ojeffreyo/PSVB_EvalBoard/pics/PSVB_EvalBoard_Top.jpg

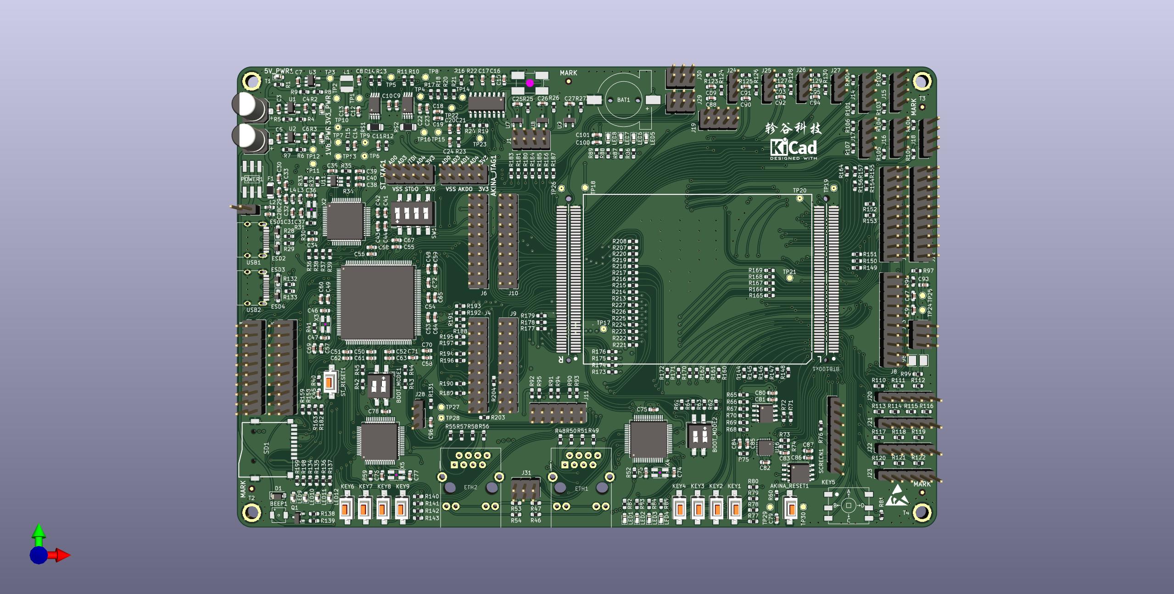
pics/PSVB_EvalBoard_Top.jpg
