ojeffreyo/PSVB_EvalBoard/pics/mimo.jpg

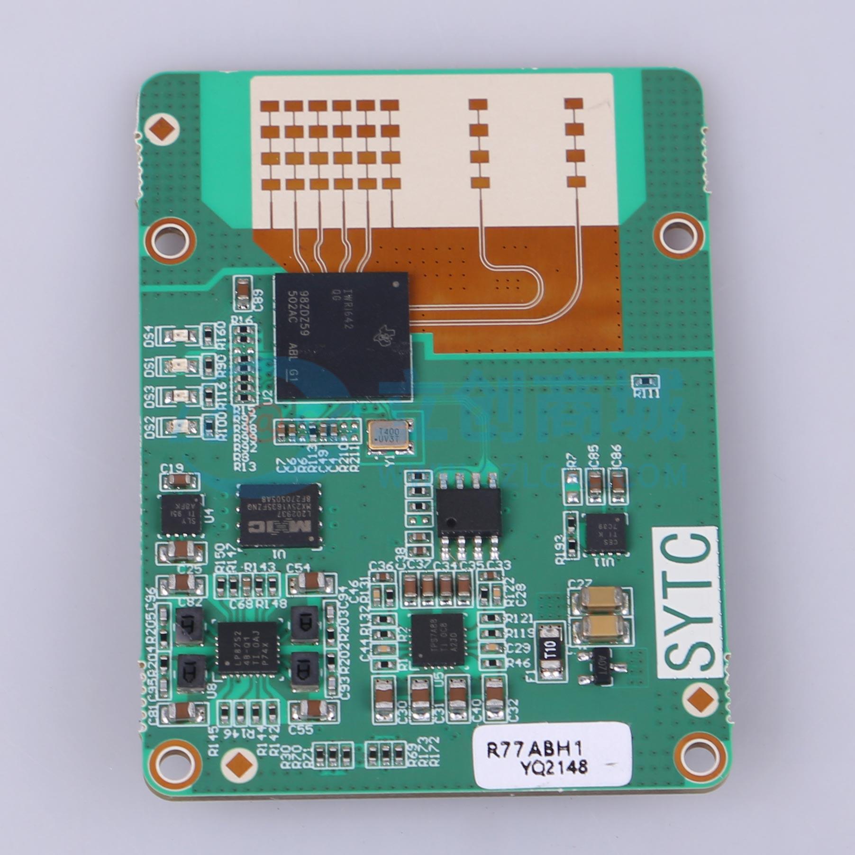
pics/mimo.jpg
