ojeffreyo/PSVB_EvalBoard/README.md

# PSVB_EvalBoard
Hardware for SoC test designed by myself.
