ojeffreyo/PSVB_EvalBoard/Layout_PDF/嘉立创SMT订单核对_PSVB_GerberV1_2023-5-18.pdf

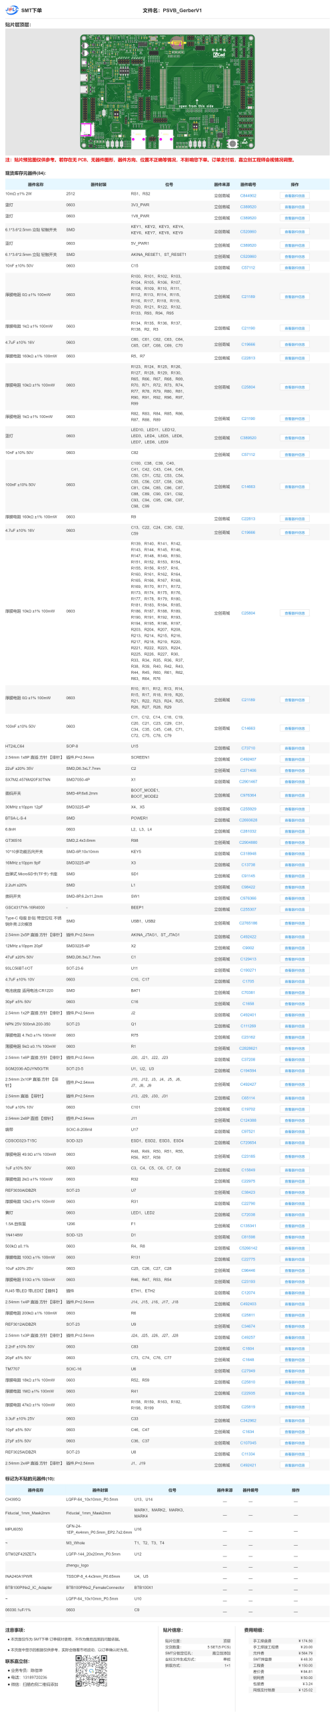
[picture p3: page 1]

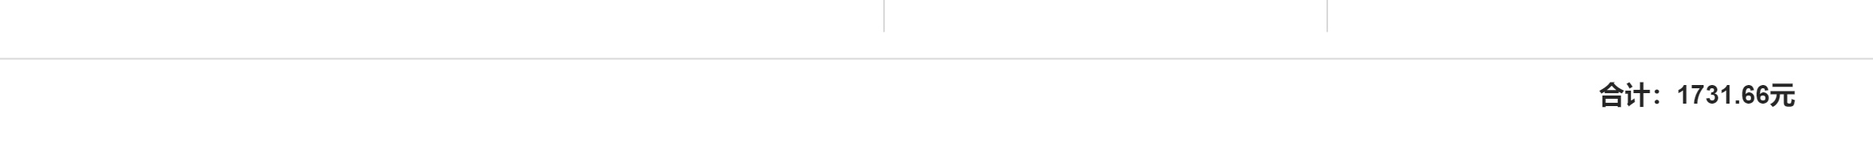
[picture p4: figure]
