ojeffreyo/PSVB_EvalBoard/datasheets/BTB_公座.png

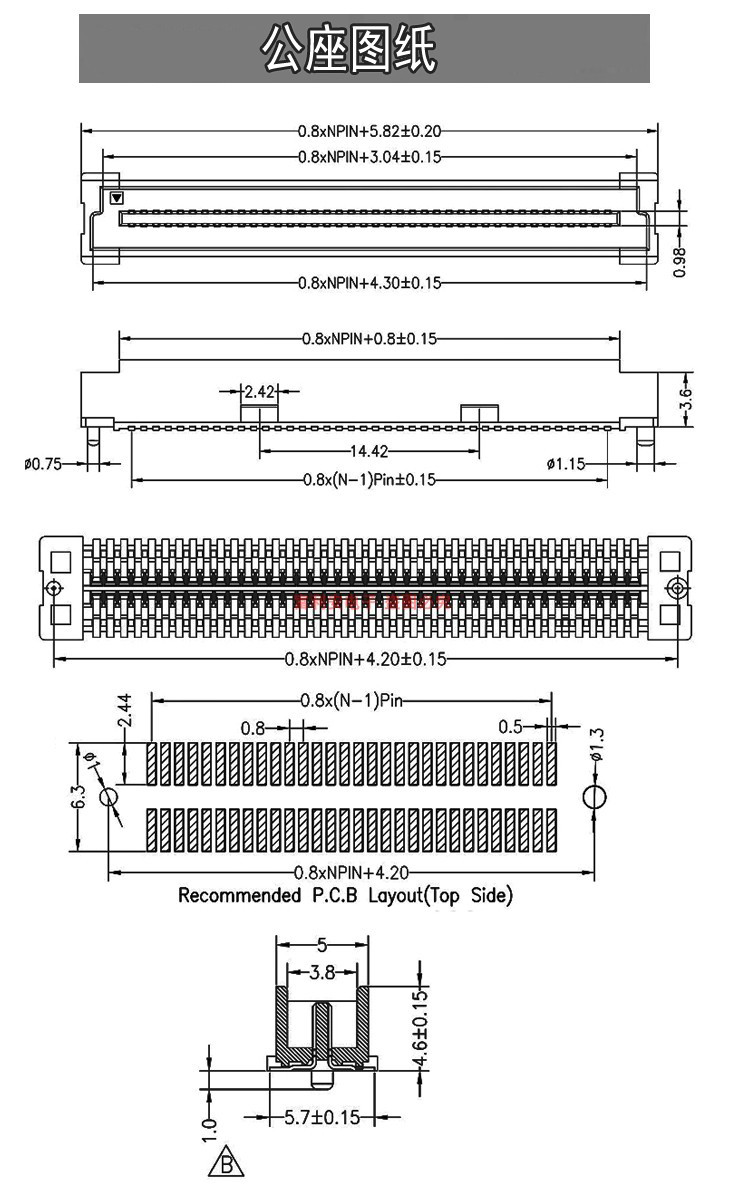
datasheets/BTB_公座.png
