ojeffreyo/PSVB_EvalBoard/datasheets/BTB_母座.png

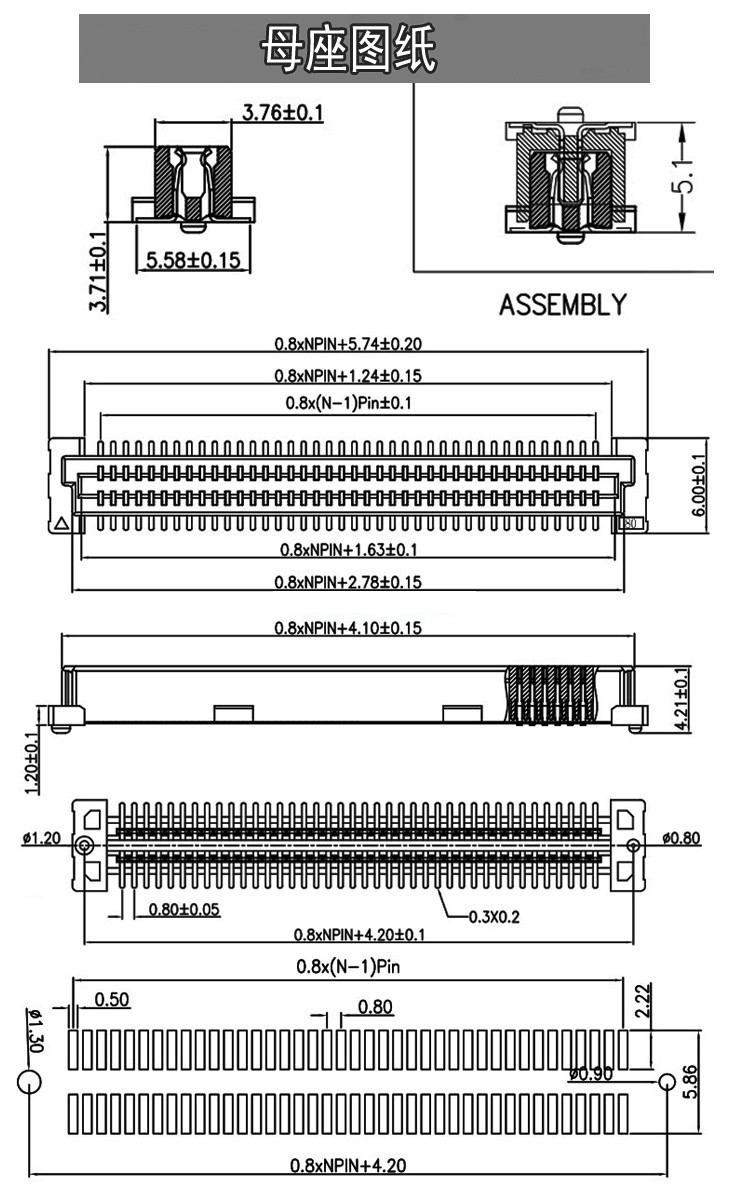
datasheets/BTB_母座.png
