ojeffreyo/PSVB_EvalBoard/pics/pic2.jpg

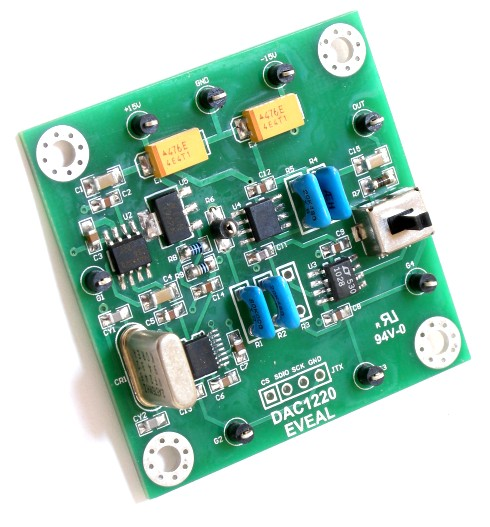
pics/pic2.jpg
