ojeffreyo/PSVB_EvalBoard/pics/PSVB_EvalBoard2.jpg

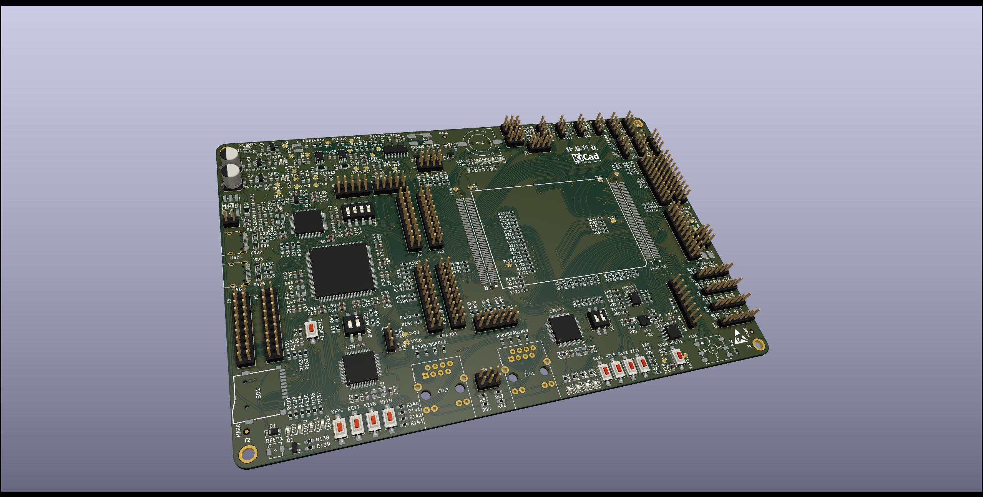
pics/PSVB_EvalBoard2.jpg
