ojeffreyo/PSVB_EvalBoard/pics/PSVB_EvalBoard.jpg

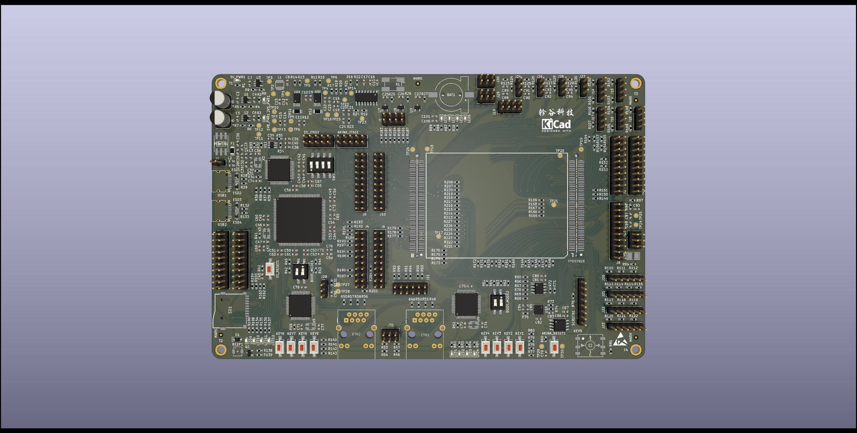
pics/PSVB_EvalBoard.jpg
