ojeffreyo/PSVB_EvalBoard/pics/PSVB_EvalBoard_Bottom.jpg

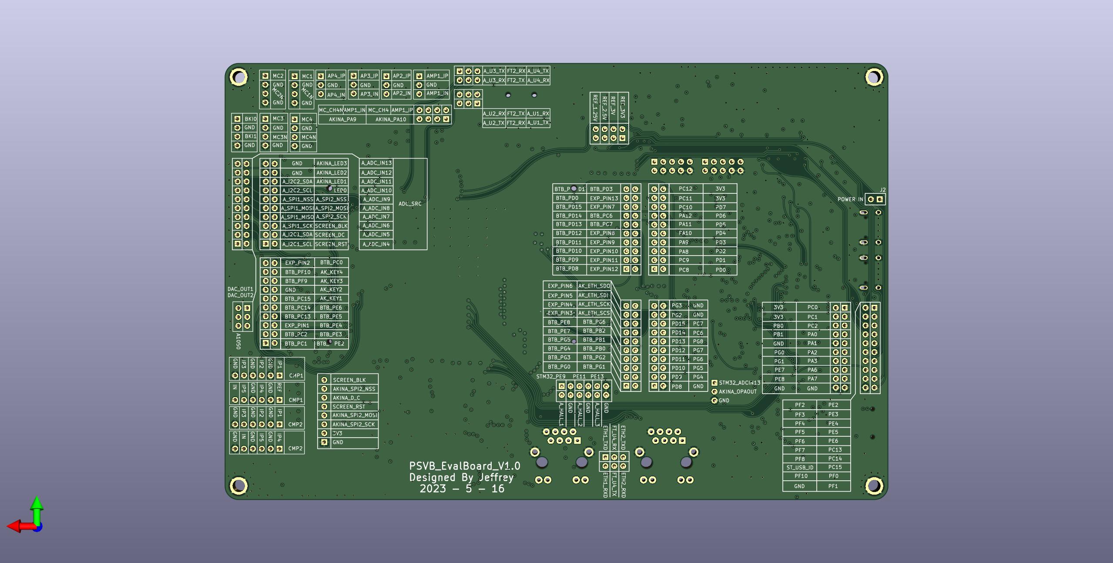
pics/PSVB_EvalBoard_Bottom.jpg
