ojeffreyo/PSVB_EvalBoard/PSVB_EvalBoard.pdf

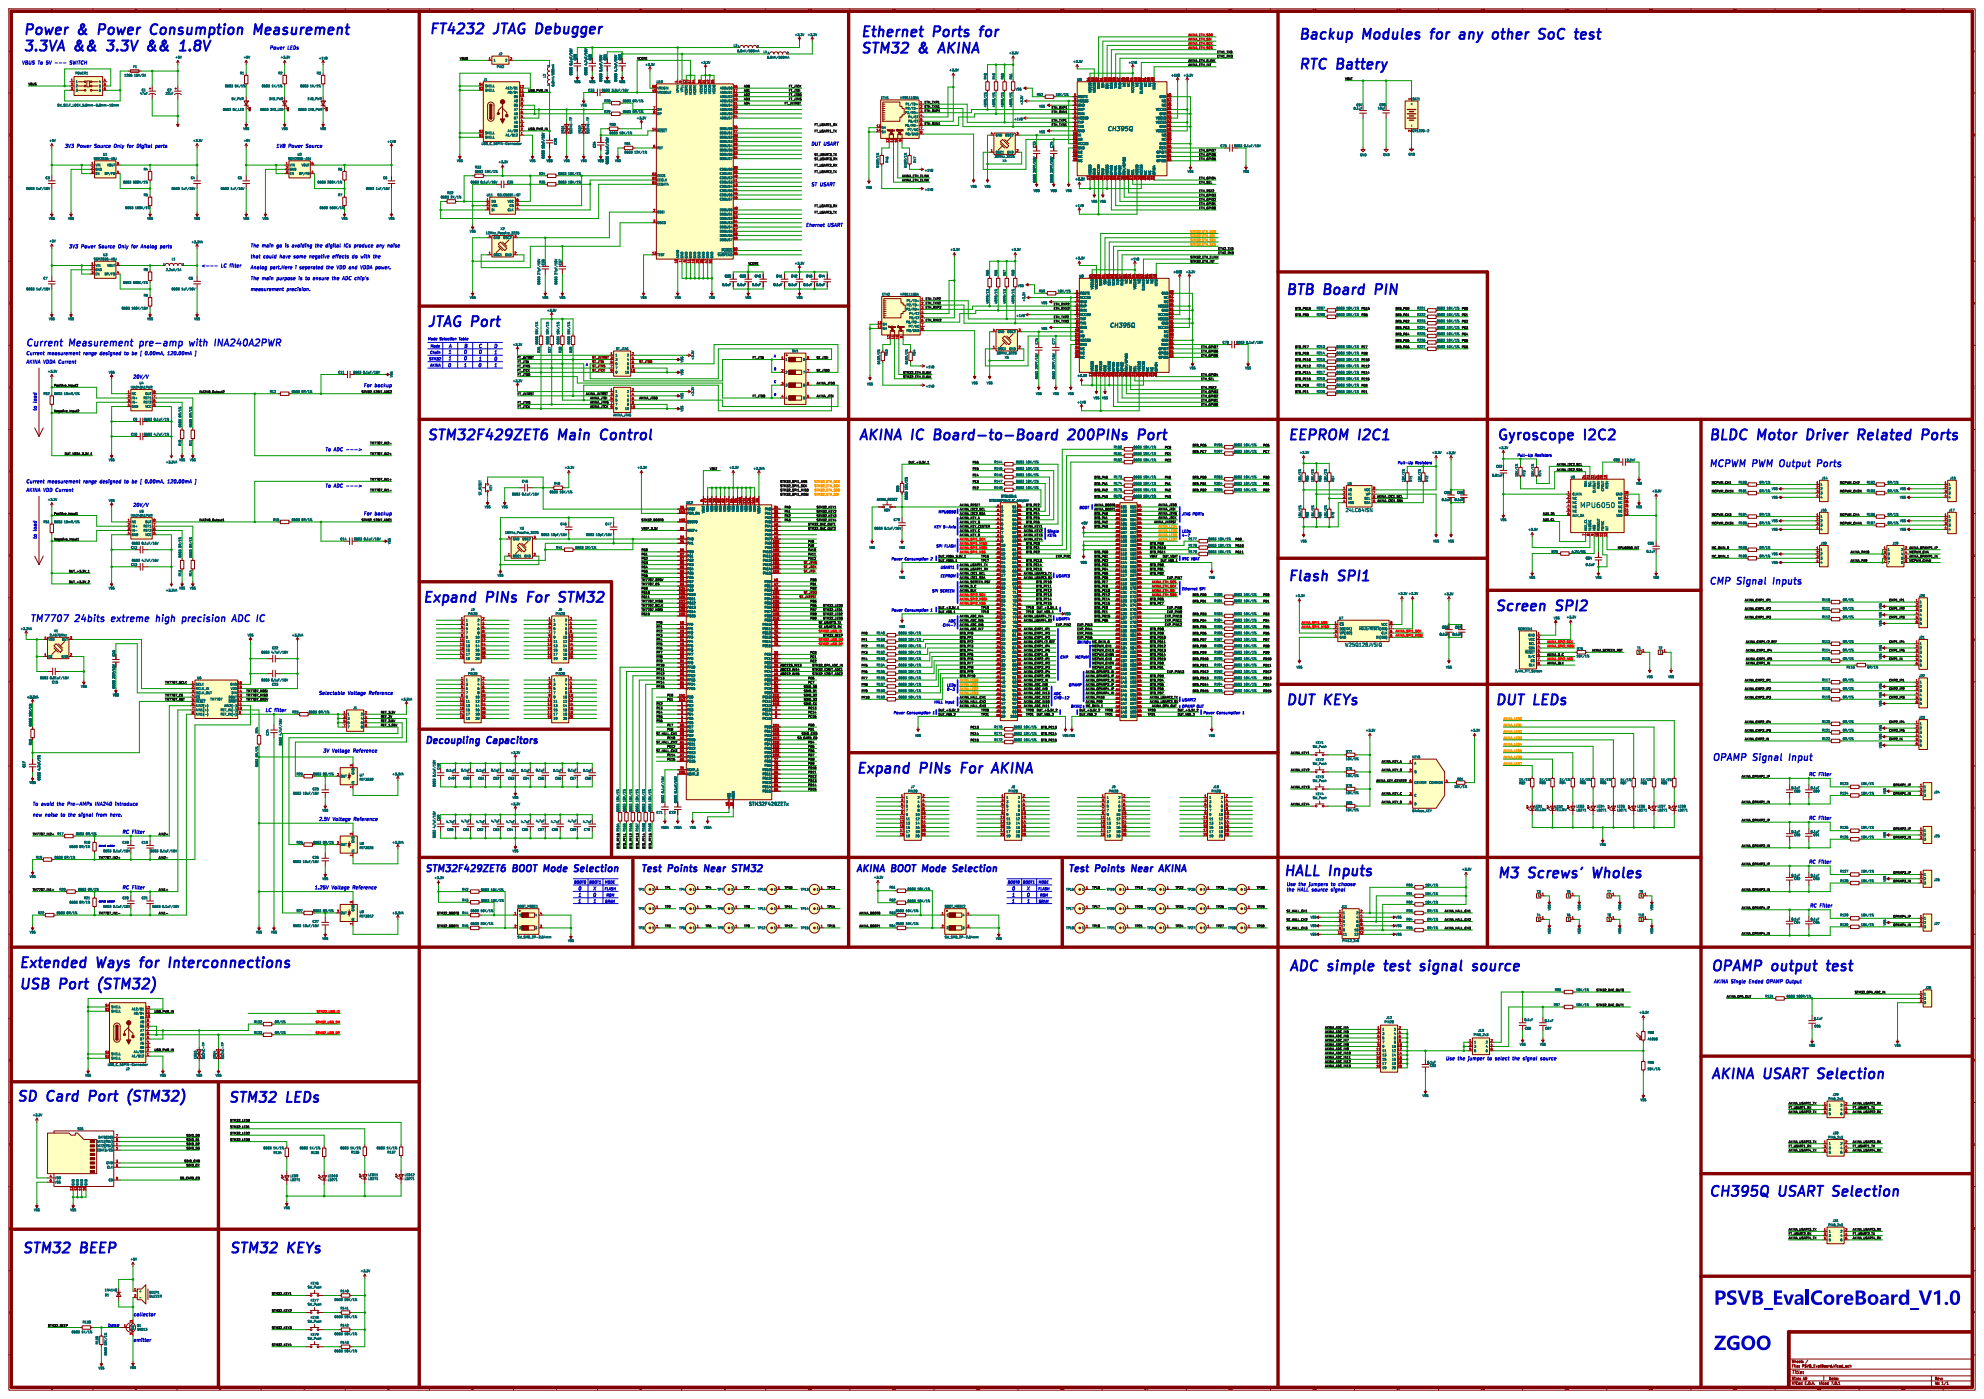
[picture p11: page 1]

Power & Power Consumption Measurement

1 AGND 10 GND 11 VCORE 12 TEST

DUT USART 3V3 Power Source Only for Digital parts

3V3 Power Source Only for Analog parts

The main go is avoiding the digital ICs produce any noise

that could have some negative effects do with the

Analog part.Here i seperated the VDD and VDDA power.

The main purpose is to ensure the ADC chip's

Mode Selection Table Chain

Current measurement range designed to be [ 0.00mA, 120.00mA ]
AKINA VDDA Current
1 to load

BLDC Motor Driver Related Ports

MCPWM PWM Output Ports

Positive_Input1
Expand PINs For STM32 to load

OPAMP OUT OPAMP KEY 5-AxisADC

TM7707 24bits extreme high precision ADC IC

To avoid the Pre-AMPs INA240 introduce new noise to the signal from here. donot solder

AKINA BOOT Mode Selection

Use the jumpers to choose
the HALL source signal

VSS
Extended Ways for Interconnections
USB Port (STM32)

ADC simple test signal source

AKINA Single Ended OPAMP Output
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
