ojeffreyo/PSVB_EvalBoard/Layout_PDF/PSVB_EvalBoard-B_Cu.pdf

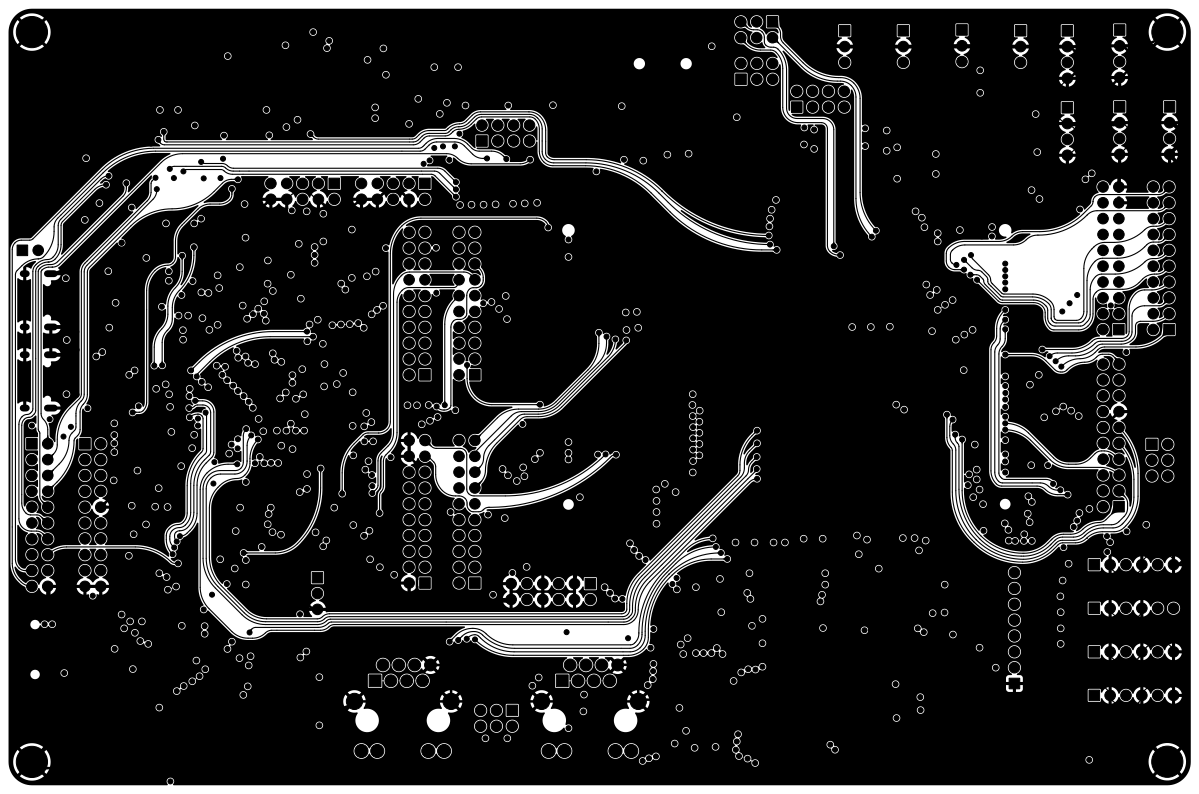
[picture p12: page 1]
