ojeffreyo/PSVB_EvalBoard/Layout_PDF/PSVB_EvalBoard-F_Cu.pdf

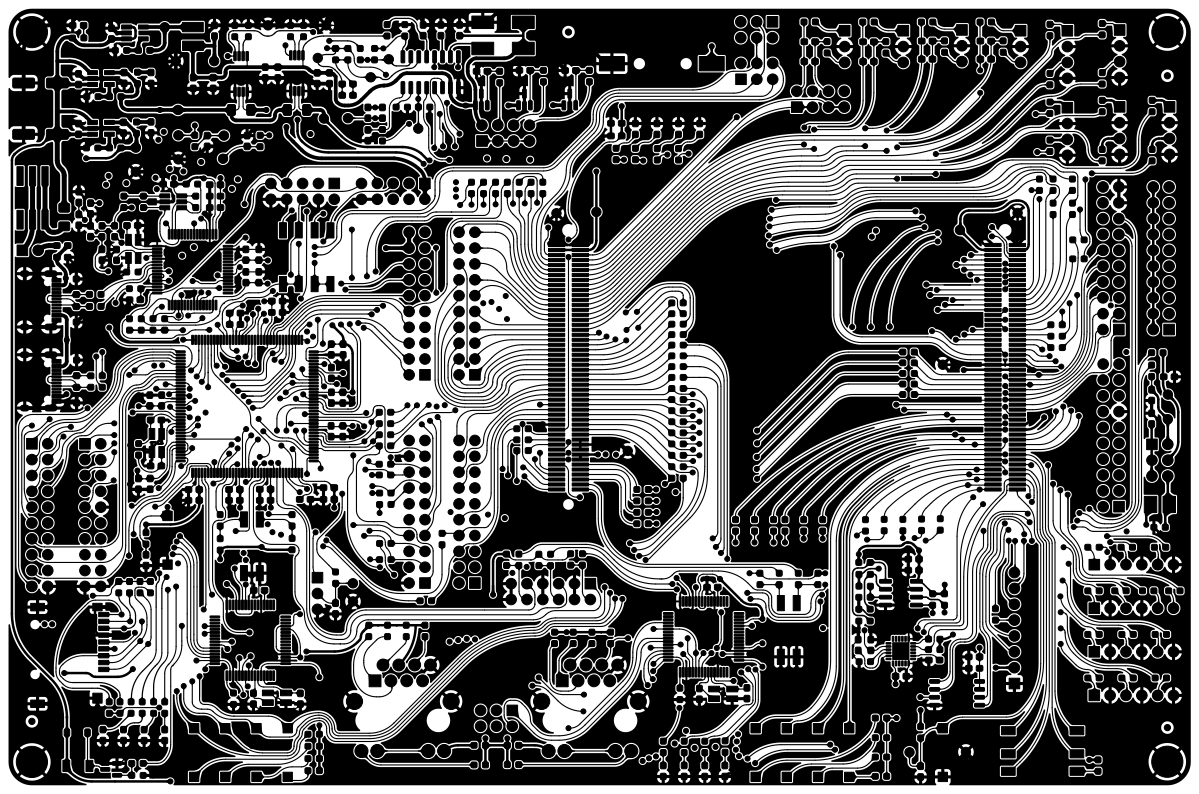
[picture p13: page 1]
