ojeffreyo/PSVB_EvalBoard/Layout_PDF/PSVB_EvalBoard-In1_Cu.pdf

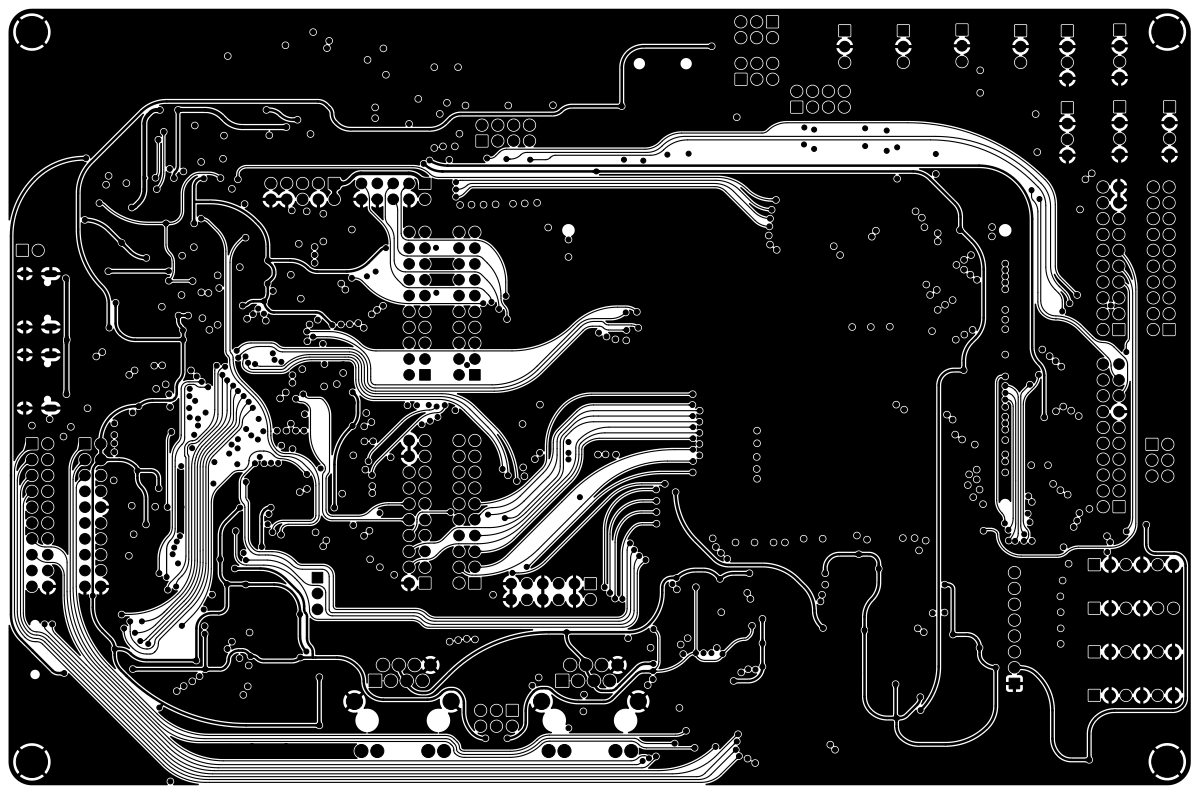
[picture p14: page 1]
