ojeffreyo/PSVB_EvalBoard/Layout_PDF/PSVB_EvalBoard-In2_Cu.pdf

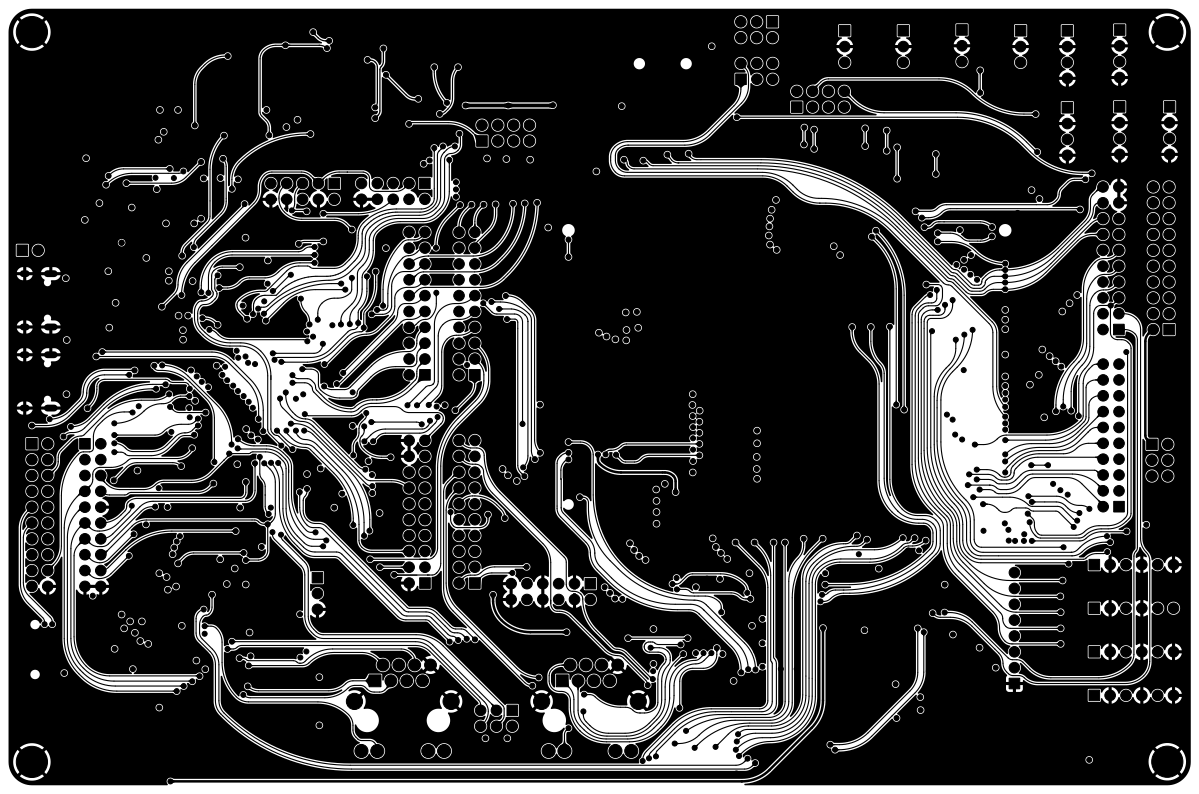
[picture p15: page 1]
