ojeffreyo/PSVB_EvalBoard/PSVB_EvalBoard/PSVB_EvalBoard.kicad_pcb

## KiCad design PSVB_EvalBoard/PSVB_EvalBoard.kicad_pcb (2023-05-12)

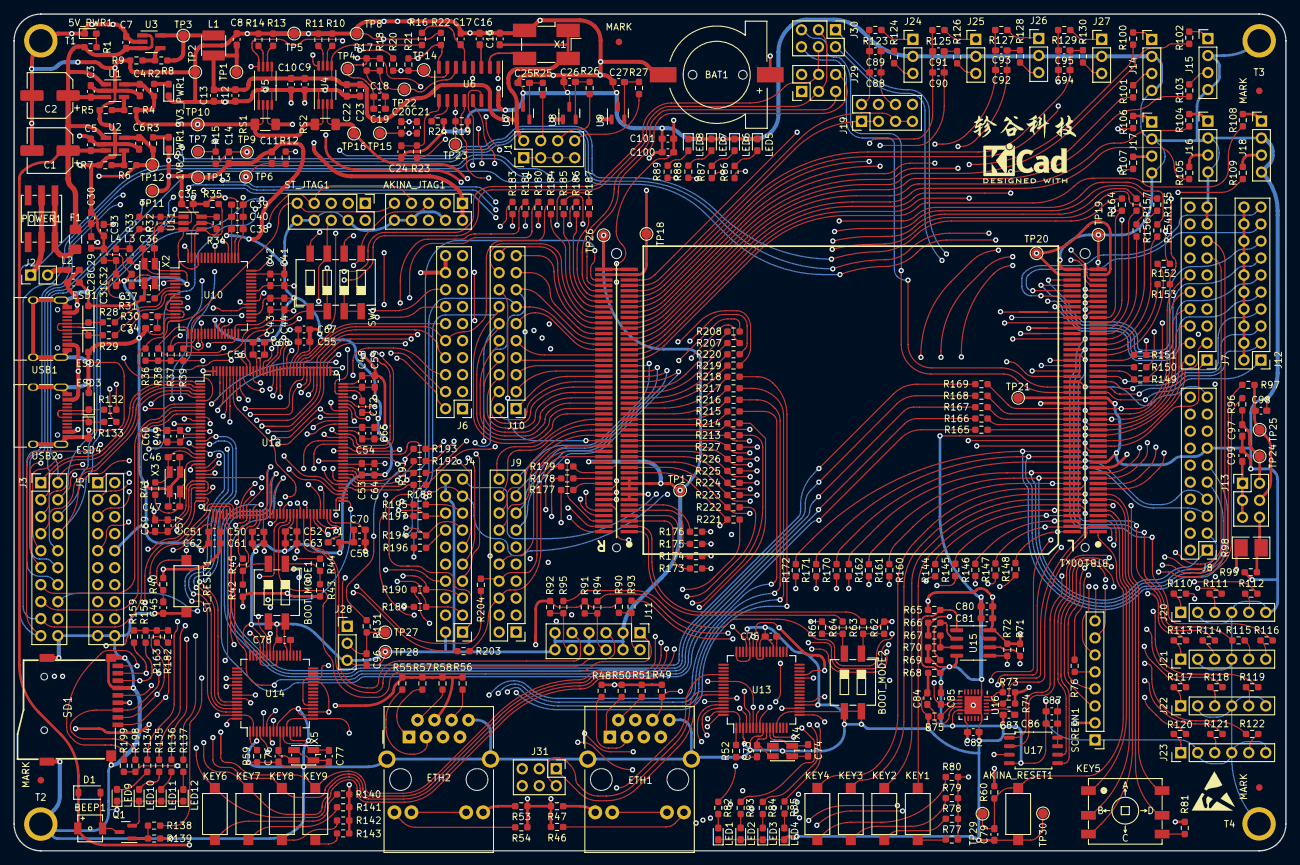
[picture p16: board PSVB_EvalBoard.kicad_pcb from above]

Board: 4 copper layers, 190.0 x 125.0 mm, 463 parts (0 on the bottom side), 461 nets.

Parts:
1V8_PWR1: 0603 1V8_PWR; LED_0603_1608Metric_Pad1.05x0.95mm_HandSolder
3V3_PWR1: 0603 3V3_LED; LED_0603_1608Metric_Pad1.05x0.95mm_HandSolder
5V_PWR1: 0603 5V_LED; LED_0603_1608Metric_Pad1.05x0.95mm_HandSolder
AKINA_JTAG1: PinHeader_2x05_P2.54mm_Vertical
AKINA_RESET1: KEY; SW_SPST_CK_RS282G05A3
BAT1: CR1220-2; CR1220_Holder
BEEP1: BUZZER; BEEP_4317
BOOT_MODE1, BOOT_MODE2: SW_SMD_2P-2.54mm; SW_DIP_SPSTx02_Slide_6.7x6.64mm_W8.61mm_P2.54mm_LowProfile
BTB100x1: BTB100PINx2_IC_Adapter; BTB100PINx2_FemaleConnector
C1: 47uF; CP_Elec_6.3x7.7
C2: 22uF; CP_Elec_6.3x7.7
C3, C4, C5, C6, C7, C8: 0603 1uF/16V; C_0603_1608Metric_Pad1.08x0.95mm_HandSolder
C9: 0603 0.1uF/1%; C_0603_1608Metric_Pad1.08x0.95mm_HandSolder
C10, C17: 0603 4.7uF/1%; C_0603_1608Metric_Pad1.08x0.95mm_HandSolder
C11, C12, C14, C18, C19, C20, C21, C23, C29, C31, C34, C35, C45, C48, C71, C72, C75, C78, C79: 0603 0.1uF/16V; C_0603_1608Metric_Pad1.08x0.95mm_HandSolder
C13, C22, C24, C30, C32, C59: 0603 4.7uF/16V; C_0603_1608Metric_Pad1.08x0.95mm_HandSolder
C15: 0603 0.01uF/16V; C_0603_1608Metric_Pad1.08x0.95mm_HandSolder
C16: 0603 30P/16V; C_0603_1608Metric_Pad1.08x0.95mm_HandSolder
C25, C26, C27, C28: 0603 10uF/16V; C_0603_1608Metric_Pad1.08x0.95mm_HandSolder
C33: 0603 3.3uF/16V; C_0603_1608Metric_Pad1.08x0.95mm_HandSolder
C36, C37: 0603 27pF/16V; C_0603_1608Metric_Pad1.08x0.95mm_HandSolder
C38, C39, C40, C41, C42, C43, C44, C49, C50, C51, C52, C53, C54, C55, C56, C57, C58, C80, C81, C84, C85, C86, C87, C88, C89, C90, C91, C92, C93, C94, C95, C96, C97, C98, C99, C100: 0.1uF; C_0603_1608Metric_Pad1.08x0.95mm_HandSolder
C46, C47: 0603 10pF/16V; C_0603_1608Metric_Pad1.08x0.95mm_HandSolder
C60, C61, C62, C63, C64, C65, C67, C68, C69, C70: 4.7uF; C_0603_1608Metric_Pad1.08x0.95mm_HandSolder
C73, C74, C76, C77: 0603 20PF/16V; C_0603_1608Metric_Pad1.08x0.95mm_HandSolder
C82: 0.01uF; C_0603_1608Metric_Pad1.08x0.95mm_HandSolder
C83: 2.2nF; C_0603_1608Metric_Pad1.08x0.95mm_HandSolder
C101: 10uF; C_0603_1608Metric_Pad1.08x0.95mm_HandSolder
D1: 1N4148; D_SOD-123
ESD1, ESD2, ESD3, ESD4: SD24C-TP; D_SOD-323_HandSoldering
ETH1, ETH2: HR911105A; RJ45_HanRun_HR911105A
F1: 1206 10V/2A; Fuse_1206_3216Metric_Pad1.42x1.75mm_HandSolder
J1, J19: PinHeader_2x04_P2.54mm_Vertical
J2: PIN2; PinHeader_1x02_P2.54mm_Vertical
J3, J4, J5, J6, J7, J8, J9, J10, J12: PIN20; PinHeader_2x10_P2.54mm_Vertical
J11: PIN12_2x6; PinHeader_2x06_P2.54mm_Vertical
J13, J29, J30, J31: PIN6_2x3; PinHeader_2x03_P2.54mm_Vertical
J14, J15, J16, J17, J18: PinHeader_1x04_P2.54mm_Vertical
J20, J21, J22, J23: PinHeader_1x06_P2.54mm_Vertical
J24, J25, J26, J27, J28: PinHeader_1x03_P2.54mm_Vertical
KEY1, KEY2, KEY3, KEY4, KEY6, KEY7, KEY8, KEY9: SW_Push; SW_SPST_CK_RS282G05A3
KEY5: 5Axises_KEY; 5Axises_Key
L1: 2.2uH/1A; SWPA3010
L2, L3, L4: 6.8nH/500mA; L_0603_1608Metric_Pad1.05x0.95mm_HandSolder
LED1, LED2: YELLOW; LED_0603_1608Metric_Pad1.05x0.95mm_HandSolder
LED3, LED4, LED5, LED6, LED7, LED8, LED9, LED10, LED11, LED12: LD271; LED_0603_1608Metric_Pad1.05x0.95mm_HandSolder
MARK: Fiducial_1mm_Mask2mm
MARK#2, MARK#3, MARK#4: Fiducial_1mm_Mask2mm
POWER1: SW_SELF_LOCK_5.8mm-5.8mm-10mm; SelfLock_Switch
Q1: S9013; SOT-23
R1: 0603 5K/1%; R_0603_1608Metric_Pad0.98x0.95mm_HandSolder
R2, R3, R134, R135, R136, R137, R138: 0603 1K/1%; R_0603_1608Metric_Pad0.98x0.95mm_HandSolder
R4, R8: 0603 500K/1%; R_0603_1608Metric_Pad0.98x0.95mm_HandSolder
R5, R7: 0603 160K/1%; R_0603_1608Metric_Pad0.98x0.95mm_HandSolder
R6: 0603 200K/1%; R_0603_1608Metric_Pad0.98x0.95mm_HandSolder
R9: 0603 160K/16V; R_0603_1608Metric_Pad0.98x0.95mm_HandSolder
R10, R11, R12, R13, R14, R15, R17, R18, R19, R20, R21, R22, R23, R24, R25, R26, R27, R28, R29: 0603 0R/1%; R_0603_1608Metric_Pad0.98x0.95mm_HandSolder
R16, R30, R33, R34, R35, R36, R37, R38, R39, R40, R42, R43, R44, R45, R60, R61, R62, R63, R64, R76, R139, R140, R141, R142, R143, R144, R145, R146, R147, R148, R149, R150, R151, R152, R153, R154, R155, R156, R157, R160, R161, R162, R164, R165, R166, R167, R168, R169, R170, R171, R172, R173, R174, R175, R176, R177, R178, R179, R180, R181, R183, R184, R185, R186, R187, R188, R189, R190, R191, R192, R193, R194, R195, R196, R197, R203, R204, R207, R208, R213, R214, R215, R216, R217, R218, R219, R220, R221, R222, R223, R224, R225, R226, R227: 0603 10K/1%; R_0603_1608Metric_Pad0.98x0.95mm_HandSolder
R31: 0603 12K/1%; R_0603_1608Metric_Pad0.98x0.95mm_HandSolder
R32: 0603 2K/1%; R_0603_1608Metric_Pad0.98x0.95mm_HandSolder
R41: 0603 1M/1%; R_0603_1608Metric_Pad0.98x0.95mm_HandSolder
R46, R47, R53, R54: 510R/1%; R_0603_1608Metric_Pad0.98x0.95mm_HandSolder
R48, R49, R50, R51, R55, R56, R57, R58: 49R9/1%; R_0603_1608Metric_Pad0.98x0.95mm_HandSolder
R52, R59: 18K/1%; R_0603_1608Metric_Pad0.98x0.95mm_HandSolder
R65, R66, R67, R68, R69, R70, R71, R72, R73, R74, R77, R78, R79, R80, R81, R90, R91, R92, R96, R97, R99, R123, R124, R125, R126, R127, R128, R129, R130: 10K/1%; R_0603_1608Metric_Pad0.98x0.95mm_HandSolder
R75: 4.7K/1%; R_0603_1608Metric_Pad0.98x0.95mm_HandSolder
R82, R83, R84, R85, R86, R87, R88, R89: 1K/1%; R_0603_1608Metric_Pad0.98x0.95mm_HandSolder
R93, R94, R95, R100, R101, R102, R103, R104, R105, R106, R107, R108, R109, R110, R111, R112, R113, R114, R115, R116, R117, R118, R119, R120, R121, R122, R132, R133: 0R/1%; R_0603_1608Metric_Pad0.98x0.95mm_HandSolder
R98: A1050; GT36516
R131: 0603 100R/1%; R_0603_1608Metric_Pad0.98x0.95mm_HandSolder
R158, R159, R163, R182, R198, R199: 0603 47K/1%; R_0603_1608Metric_Pad0.98x0.95mm_HandSolder
RS1, RS2: 0603 10mR/1%; R_1206_3216Metric_Pad1.30x1.75mm_HandSolder
SCREEN1: 2.4In_TFT_Screen; PinHeader_1x08_P2.54mm_Vertical
SD1: TF-SMD_TF-02
ST_JTAG1: PinHeader_2x05_P2.54mm_Vertical
ST_RESET1: KEY; SW_SPST_CK_RS282G05A3
SW1: SW_DIP_SPSTx04_Slide_6.7x11.72mm_W8.61mm_P2.54mm_LowProfile
T1, T2, T3, T4: M3_Whole
TP1, TP2, TP3, TP4, TP5, TP6, TP7, TP8, TP9, TP10, TP11, TP12, TP13, TP14, TP15, TP16, TP17, TP18, TP19, TP20, TP21, TP22, TP23, TP24, TP25, TP26, TP27, TP28, TP29, TP30: TestPoint_1.5mm; TestPoint_Pad_D1.5mm
U1, U2, U3: SGM2036-ADJ; SOT-23-5_HandSoldering
U4, U5: INA240A1PWR; TSSOP-8_4.4x3mm_P0.65mm
U6: TM7707; SOIC-16_3.9x9.9mm_P1.27mm
U7: REF3030; SOT-23
U8: REF3025; SOT-23
U9: REF3012; SOT-23
U10: LQFP-64_10x10mm_P0.5mm
U11: 93LC56BT-IOT; SOT-23-6_Handsoldering
U12: STM32F429ZETx; LQFP-144_20x20mm_P0.5mm
U13, U14: CH395Q; LQFP-64_10x10mm_P0.5mm
U15: 24LC64ISN; SOIC-8_3.9x4.9mm_P1.27mm
U16: MPU6050; QFN-24-1EP_4x4mm_P0.5mm_EP2.7x2.6mm
U17: W25Q128JVSIQ; SOIC-8_5.275x5.275mm_P1.27mm
USB1, USB2: USB_C_16PIN-Connector; USB_C_PIN16
X1: 2.4576Mhz; Oscillator_SMD_EuroQuartz_XO91-4Pin_7.0x5.0mm_HandSoldering
X2: 12Mhz_Passive_3225; Oscillator_SMD_EuroQuartz_XO32-4Pin_3.2x2.5mm_HandSoldering
X3: 16Mhz_Passive_3225; Oscillator_SMD_EuroQuartz_XO32-4Pin_3.2x2.5mm_HandSoldering
X4, X5: 30Mhz_3225; Oscillator_SMD_EuroQuartz_XO32-4Pin_3.2x2.5mm_HandSoldering

Connections:
+1V8: C6.1, R3.2, R6.2, R46.2, R47.2, R53.2, R54.2, TP12.1, U2.5 (VOUT), U13.6 (VCC18), U13.19 (VCC18), U13.28 (VCC18), U13.43 (VCC18), U13.54 (VCC18), U13.64 (VCC18), U14.6 (VCC18), U14.19 (VCC18), U14.28 (VCC18), U14.43 (VCC18), U14.54 (VCC18), U14.64 (VCC18)
+3.3VA: C8.1, C9.2, C10.2, C12.2, C13.2, C15.1, C22.1, C23.1, J1.2, L1.2, R16.2, TP1.1, U4.5 (VCC), U5.5 (VCC), U6.15 (VDD), U7.1 (IN), U8.1 (IN), U9.1 (IN), X1.1 (OE), X1.4 (VDD)
+3V3: AKINA_JTAG1.1, AKINA_JTAG1.2, C4.1, C35.1, C41.2, C42.2, C43.2, C44.2, C48.1, C49.1, C50.1, C51.1, C52.1, C53.1, C54.1, C55.1, C56.1, C57.1, C58.1, C59.1, C60.1, C61.1, C62.1, C63.1, C64.1, C65.1, C67.1, C68.1, C69.1, C70.1, C80.1, C81.1, C82.1, C85.1, C86.1, C87.1, ETH1.4 (P4/CT), ETH1.5 (P5/CT), ETH2.4 (P4/CT), ETH2.5 (P5/CT), J5.2, J5.4, J6.18, J6.20, L3.2, L4.2, R2.2, R4.2, R30.1, R33.1, R34.2, R35.2, R36.1, R37.1, R38.1, R39.1, R40.1, R42.2, R43.2, R48.1, R49.1, R50.1, R51.1, R55.1, R56.1, R57.1, R58.1, R61.2, R62.2, R65.1, R66.1, R67.1, R71.1, R72.1, R73.1, R74.1, R77.2, R78.2, R79.2, R80.2, R81.2, R90.2, R91.2, R92.2, R98.1, R140.2, R141.2, R142.2, R143.2, R158.2, R159.2, R163.2, R182.2, R198.2, R199.2, RS1.1, RS2.1, SCREEN1.2 (VCC), SD1.4 (VDD), ST_JTAG1.1, ST_JTAG1.2, TP10.1, U1.5 (VOUT), U4.2 (IN+), U5.2 (IN+), U10.20 (VCCIO), U10.31 (VCCIO), U10.42 (VCCIO), U10.50 (VREGIN), U10.56 (VCCIO), U11.6 (VCC), U12.17 (VDD), U12.30 (VDD), U12.33 (VDDA), U12.39 (VDD), U12.52 (VDD), U12.62 (VDD), U12.72 (VDD), U12.84 (VDD), U12.95 (VDD), U12.108 (VDD), U12.121 (VDD), U12.131 (VDD), U12.143 (PDR_ON), U12.144 (VDD), U13.2 (VCC33), U13.12 (VCC33), U13.17 (VCC33), U13.21 (VCC33), U13.29 (VCC33), U13.40 (VCC33), U13.42 (VCC33), U13.45 (VCC33), U13.63 (VCC33), U14.2 (VCC33), U14.12 (VCC33), U14.17 (VCC33), U14.21 (VCC33), U14.29 (VCC33), U14.40 (VCC33), U14.42 (VCC33), U14.45 (VCC33), U14.63 (VCC33), U15.8 (VCC), U16.8 (VLOGIC), U16.13 (VDD), U17.3 (~WP(IO2)), U17.7 (~HOLD/RESET(IO3)), U17.8 (VCC)
+5V: BEEP1.1 (+), BTB100x1.107, BTB100x1.108, C1.1, C2.1, C3.1, C5.1, C7.1, D1.1 (K), F1.1, R1.1, U1.1 (VIN), U1.3 (EN), U2.1 (VIN), U2.3 (EN), U3.1 (VIN), U3.3 (EN)
/AD0: AKINA_JTAG1.9, BTB100x1.154, R36.2, ST_JTAG1.9, U10.16 (ADBUS0), U12.109 (PA14)
/AD1: AKINA_JTAG1.5, BTB100x1.152, R38.2, SW1.1, SW1.2, SW1.5, U10.17 (ADBUS1)
/AD2: SW1.3, SW1.4, U10.18 (ADBUS2)
/AD3: AKINA_JTAG1.7, BTB100x1.153, R37.2, ST_JTAG1.7, U10.19 (ADBUS3), U12.105 (PA13)
/AD4: AKINA_JTAG1.3, BTB100x1.155, R39.2, ST_JTAG1.3, U10.21 (ADBUS4), U12.134 (PB4)
/ADC12_IN14: C14.1, R15.2, TP9.1, U12.44 (PC4)
/ADC12_IN15: C11.2, R12.2, TP6.1, U12.45 (PC5)
/ADC123_IN13: J28.1, U12.29 (PC3)
/AIN1+: C20.1, C21.1, R20.2, R21.2, TP14.1, U6.7 (AIN1(+))
/AIN1-: C20.2, C21.2, R21.1, R22.2, TP15.1, U6.8 (AIN1(-))
/AIN2+: C18.1, C19.1, R17.2, R18.2, TP22.1, U6.6 (AIN2(+))
/AIN2-: C18.2, C19.2, R12.1, R17.1, R18.1, R19.2, TP4.1, TP23.1, U4.8 (OUT), U6.11 (AIN2(-))
/AKINA_ADC_IN4: BTB100x1.27, J12.1
/AKINA_ADC_IN5: BTB100x1.28, J12.3
/AKINA_ADC_IN6: BTB100x1.29, J12.5
/AKINA_ADC_IN7: BTB100x1.30, J12.7
/AKINA_ADC_IN8: BTB100x1.93, J12.9
/AKINA_ADC_IN9: BTB100x1.94, J12.11
/AKINA_ADC_IN10: BTB100x1.97, J12.13
/AKINA_ADC_IN11: BTB100x1.98, J12.15
/AKINA_ADC_IN12: BTB100x1.96, J12.17
/AKINA_ADC_IN13: BTB100x1.95, J12.19
/AKINA_BLK: BTB100x1.21, J7.6, SCREEN1.8 (BLK)
/AKINA_BOOT0: BTB100x1.101, R64.2
/AKINA_BOOT1: BTB100x1.102, R63.2
/AKINA_CMP1_IN: BTB100x1.86, R116.1
/AKINA_CMP1_IP1: BTB100x1.80, R110.1
/AKINA_CMP1_IP2: BTB100x1.81, R111.1
/AKINA_CMP1_IP3: BTB100x1.82, R112.1
/AKINA_CMP1_IP4: BTB100x1.84, R114.1
/AKINA_CMP1_IP5: BTB100x1.85, R115.1
/AKINA_CMP1/2_REF: BTB100x1.83, R113.1
/AKINA_CMP2_IN: BTB100x1.92, R122.1
/AKINA_CMP2_IP1: BTB100x1.87, R117.1
/AKINA_CMP2_IP2: BTB100x1.88, R118.1
/AKINA_CMP2_IP3: BTB100x1.89, R119.1
/AKINA_CMP2_IP4: BTB100x1.90, R120.1
/AKINA_CMP2_IP5: BTB100x1.91, R121.1
/AKINA_D_C: BTB100x1.20, J7.4, SCREEN1.6 (D/C)
/AKINA_ETH_ELINK: ETH1.10, ETH1.11, U13.52 (ELINK#)
/AKINA_ETH_SCK: BTB100x1.170, J9.16, U13.60 (SCK)
/AKINA_ETH_SCS: BTB100x1.169, J9.14, U13.59 (SCS)
/AKINA_ETH_SDI: BTB100x1.171, J9.18, U13.61 (SDI)
/AKINA_ETH_SDO: BTB100x1.172, J9.20, U13.62 (SDO)
/AKINA_HALL_CH1: BTB100x1.46, R93.2
/AKINA_HALL_CH2: BTB100x1.47, R94.2
/AKINA_HALL_CH3: BTB100x1.48, R95.2
/AKINA_I2C1_SCL: BTB100x1.17, J7.1, R71.2, U15.6 (SCL)
/AKINA_I2C1_SDA: BTB100x1.18, J7.3, R72.2, U15.5 (SDA)
/AKINA_I2C2_SCL: BTB100x1.2, J7.13, R74.2, U16.23 (SCL)
/AKINA_I2C2_SDA: BTB100x1.3, J7.15, R73.2, U16.24 (SDA)
/AKINA_JTDO: AKINA_JTAG1.6, BTB100x1.151, SW1.6
/AKINA_KEY1: BTB100x1.56, J8.12, KEY1.1
/AKINA_KEY2: BTB100x1.57, J8.14, KEY2.1
/AKINA_KEY3: BTB100x1.58, J8.16, KEY3.1
/AKINA_KEY4: BTB100x1.59, J8.18, KEY4.1
/AKINA_KEY_A: BTB100x1.4, KEY5.1 (A)
/AKINA_KEY_B: BTB100x1.5, KEY5.2 (B)
/AKINA_KEY_C: BTB100x1.7, KEY5.3 (C)
/AKINA_KEY_CENTER: BTB100x1.6, KEY5.6 (CENTER)
/AKINA_KEY_D: BTB100x1.8, KEY5.5 (D)
/AKINA_LED0: BTB100x1.42, J7.14, R89.1
/AKINA_LED1: BTB100x1.43, J7.16, R88.1
/AKINA_LED2: BTB100x1.44, J7.18, R87.1
/AKINA_LED3: BTB100x1.45, J7.20, R86.1
/AKINA_LED4: BTB100x1.156, R85.1
/AKINA_LED5: BTB100x1.157, R84.1
/AKINA_LED6: BTB100x1.158, R83.1
/AKINA_LED7: BTB100x1.159, R82.1
/AKINA_OPAMP1_IN: C88.1, C89.1, J19.6, R124.1
/AKINA_OPAMP1_IP: C88.2, C89.2, J19.2, R123.1
/AKINA_OPAMP2_IN: BTB100x1.142, C90.1, C91.1, R126.1
/AKINA_OPAMP2_IP: BTB100x1.143, C90.2, C91.2, R125.1
/AKINA_OPAMP3_IN: BTB100x1.140, C92.1, C93.1, R128.1
/AKINA_OPAMP3_IP: BTB100x1.141, C92.2, C93.2, R127.1
/AKINA_OPAMP4_IN: BTB100x1.145, C94.1, C95.1, R130.1
/AKINA_OPAMP4_IP: BTB100x1.144, C94.2, C95.2, R129.1
/AKINA_OPA_OUT: BTB100x1.198, R131.2
/AKINA_PA9: BTB100x1.147, J19.5, J19.7
/AKINA_PA10: BTB100x1.146, J19.1, J19.3
/AKINA_RESET: AKINA_RESET1.2, BTB100x1.1, C79.1, R60.1, TP29.1
/AKINA_SCREEN_RST: BTB100x1.19, J7.2, R76.2
/AKINA_SPI1_MISO: BTB100x1.10, J7.7, U17.2 (DO(IO1))
/AKINA_SPI1_MOSI: BTB100x1.11, J7.9, U17.5 (DI(IO0))
/AKINA_SPI1_NSS: BTB100x1.12, J7.11, U17.1 (~CS)
/AKINA_SPI1_SCK: BTB100x1.9, J7.5, U17.6 (CLK)
/AKINA_SPI2_MOSI: BTB100x1.23, J7.10, SCREEN1.4 (SDA)
/AKINA_SPI2_NSS: BTB100x1.24, J7.12, SCREEN1.7 (CS)
/AKINA_SPI2_SCK: BTB100x1.22, J7.8, SCREEN1.3 (SCL)
/AKINA_USART1_RX: BTB100x1.16, J29.2
/AKINA_USART1_TX: BTB100x1.15, J29.1
/AKINA_USART2_RX: BTB100x1.197, J29.6
/AKINA_USART2_TX: BTB100x1.196, J29.5
/AKINA_USART3_RX: BTB100x1.68, J30.2
/AKINA_USART3_TX: BTB100x1.67, J30.1
/AKINA_USART4_RX: BTB100x1.78, J30.6
/AKINA_USART4_TX: BTB100x1.77, J30.5
/BTB_PA0: BTB100x1.103, R173.1
/BTB_PA1: BTB100x1.104, R174.1
/BTB_PA2: BTB100x1.105, R175.1
/BTB_PA3: BTB100x1.106, R176.1
/BTB_PB0: BTB100x1.165, J9.6, R203.1
/BTB_PB1: BTB100x1.166, J9.8, R204.1
/BTB_PB2: BTB100x1.167, J9.10
/BTB_PB5: BTB100x1.128, R208.1
/BTB_PC0: BTB100x1.60, J8.20, R160.1
/BTB_PC1: BTB100x1.61, J8.1, R161.1
/BTB_PC2: BTB100x1.62, J8.3, R162.1
/BTB_PC6: BTB100x1.173, J10.14, R196.1
/BTB_PC7: BTB100x1.174, J10.12, R197.1
/BTB_PC13: BTB100x1.64, J8.7, R170.2
/BTB_PC14: BTB100x1.65, J8.9, R171.2
/BTB_PC15: BTB100x1.66, J8.11, R172.2
/BTB_PD0: BTB100x1.188, J10.17, R180.1
/BTB_PD1: BTB100x1.189, J10.19, R181.1
/BTB_PD3: BTB100x1.190, J10.20, R183.1
/BTB_PD4: BTB100x1.192, R184.1
/BTB_PD5: BTB100x1.193, R185.1
/BTB_PD6: BTB100x1.194, R186.1
/BTB_PD7: BTB100x1.195, R187.1
/BTB_PD8: BTB100x1.180, J10.1, R188.1
/BTB_PD9: BTB100x1.181, J10.3, R189.1
/BTB_PD10: BTB100x1.182, J10.5, R190.1
/BTB_PD11: BTB100x1.183, J10.7, R191.1
/BTB_PD12: BTB100x1.184, J10.9, R192.1
/BTB_PD13: BTB100x1.185, J10.11, R193.1
/BTB_PD14: BTB100x1.186, J10.13, R194.1
/BTB_PD15: BTB100x1.187, J10.15, R195.1
/BTB_PE0: BTB100x1.125, R219.1
/BTB_PE1: BTB100x1.126, R220.1
/BTB_PE2: BTB100x1.51, J8.2, R148.2
/BTB_PE3: BTB100x1.52, J8.4, R147.2
/BTB_PE4: BTB100x1.53, J8.6, R146.2
/BTB_PE5: BTB100x1.54, J8.8, R145.2
/BTB_PE6: BTB100x1.55, J8.10, R144.2
/BTB_PE7: BTB100x1.119, J9.9, R213.1
/BTB_PE8: BTB100x1.120, J9.11, R214.1
/BTB_PE10: BTB100x1.121, R215.1
/BTB_PE12: BTB100x1.122, R216.1
/BTB_PE14: BTB100x1.123, R217.1
/BTB_PE15: BTB100x1.124, R218.1
/BTB_PF0: BTB100x1.31, R149.2
/BTB_PF1: BTB100x1.32, R150.2
/BTB_PF2: BTB100x1.33, R151.2
/BTB_PF3: BTB100x1.34, R152.2
/BTB_PF4: BTB100x1.35, R153.2
/BTB_PF5: BTB100x1.36, R154.2
/BTB_PF6: BTB100x1.37, R155.2
/BTB_PF7: BTB100x1.38, R156.2
/BTB_PF8: BTB100x1.39, R157.2
/BTB_PF9: BTB100x1.40, J8.15
/BTB_PF10: BTB100x1.41, J8.17, R164.1
/BTB_PF11: BTB100x1.70, R165.1
/BTB_PF12: BTB100x1.71, R166.1
/BTB_PF13: BTB100x1.72, R167.1
/BTB_PF14: BTB100x1.73, R168.1
/BTB_PF15: BTB100x1.74, R169.1
/BTB_PG0: BTB100x1.112, J9.1, R221.1
/BTB_PG1: BTB100x1.113, J9.2, R222.1
/BTB_PG2: BTB100x1.114, J9.4, R223.1
/BTB_PG3: BTB100x1.115, J9.3, R224.1
/BTB_PG4: BTB100x1.116, J9.5, R225.1
/BTB_PG5: BTB100x1.117, J9.7, R226.1
/BTB_PG6: BTB100x1.118, J9.12, R227.1
/BTB_PG9: BTB100x1.160, R177.1
/BTB_PG10: BTB100x1.161, R178.1
/BTB_PG11: BTB100x1.162, R179.1
/BTB_PG15: BTB100x1.127, R207.1
/CMP1_IN: J21.5, R115.2
/CMP1_IP1: J20.1, R110.2
/CMP1_IP2: J20.3, R111.2
/CMP1_IP3: J20.5, R112.2
/CMP1_IP4: J21.1, R113.2
/CMP1_IP5: J21.3, R114.2
/CMP2_IN: J23.5, R122.2
/CMP2_IP1: J22.1, R117.2
/CMP2_IP2: J22.3, R118.2
/CMP2_IP3: J22.5, R119.2
/CMP2_IP4: J23.1, R120.2
/CMP2_IP5: J23.3, R121.2
/DUT_+3.3V_1: BTB100x1.25, BTB100x1.49, BTB100x1.75, BTB100x1.99, BTB100x1.149, BTB100x1.199, R60.2, RS1.2, TP18.1, TP20.1, U5.3 (IN-)
/DUT_VBAT: BAT1.1 (+), BTB100x1.163, C100.1, C101.1, U12.6 (VBAT)
/DUT_VDDA_3.3V_1: BTB100x1.13, RS2.2, TP16.1, U4.3 (IN-)
/ETH1_RXD: J31.2, U13.57 (RXD)
/ETH1_RXN: ETH1.6 (P6/RD-), R49.2, U13.5 (RXN)
/ETH1_RXP: ETH1.3 (P3/RD+), R48.2, U13.4 (RXP)
/ETH1_TXD: J31.1, U13.58 (TXD)
/ETH1_TXN: ETH1.2 (P2/TD-), R51.2, U13.8 (TXN)
/ETH1_TXP: ETH1.1 (P1/TD+), R50.2, U13.7 (TXP)
/ETH2_RXD: J31.6, U14.57 (RXD)
/ETH2_RXN: ETH2.6 (P6/RD-), R56.2, U14.5 (RXN)
/ETH2_RXP: ETH2.3 (P3/RD+), R55.2, U14.4 (RXP)
/ETH2_TXD: J31.5, U14.58 (TXD)
/ETH2_TXN: ETH2.2 (P2/TD-), R58.2, U14.8 (TXN)
/ETH2_TXP: ETH2.1 (P1/TD+), R57.2, U14.7 (TXP)
/EXP_PIN1: BTB100x1.63, J8.5
/EXP_PIN2: BTB100x1.79, J8.19
/EXP_PIN3: BTB100x1.129, J9.13
/EXP_PIN4: BTB100x1.130, J9.15
/EXP_PIN5: BTB100x1.131, J9.17
/EXP_PIN6: BTB100x1.132, J9.19
/EXP_PIN7: BTB100x1.168, J10.16
/EXP_PIN8: BTB100x1.175, J10.10
/EXP_PIN9: BTB100x1.176, J10.8
/EXP_PIN10: BTB100x1.177, J10.6
/EXP_PIN11: BTB100x1.178, J10.4
/EXP_PIN12: BTB100x1.179, J10.2
/EXP_PIN13: BTB100x1.191, J10.18
/FT_USART2_RX: J29.3, J30.3, U10.27 (BDBUS1)
/FT_USART2_TX: J29.4, J30.4, U10.26 (BDBUS0)
/FT_USART3_RX: U10.39 (CDBUS1), U12.69 (PB10)
/FT_USART3_TX: U10.38 (CDBUS0), U12.70 (PB11)
/FT_USART4_RX: J31.3, U10.52 (DDBUS1)
/FT_USART4_TX: J31.4, U10.48 (DDBUS0)
/INA240_Output1: R15.1, R20.1, TP7.1, U5.8 (OUT)
/MCPWM_CH1: BTB100x1.134, R100.1
/MCPWM_CH1N: BTB100x1.135, R101.1
/MCPWM_CH2: BTB100x1.139, R102.1
/MCPWM_CH2N: BTB100x1.138, R103.1
/MCPWM_CH3: BTB100x1.137, R104.1
/MCPWM_CH3N: BTB100x1.136, R105.1
/MCPWM_CH4: J19.4, R106.1
/MCPWM_CH4N: J19.8, R107.1
/MC_BKIN_0: BTB100x1.133, R108.1
/MC_BKIN_1: BTB100x1.148, R109.1
/OPAMP1_IN: J24.3, R124.2
/OPAMP1_IP: J24.1, R123.2
/OPAMP2_IN: J25.3, R126.2
/OPAMP2_IP: J25.1, R125.2
/OPAMP3_IN: J26.3, R128.2
/OPAMP3_IP: J26.1, R127.2
/OPAMP4_IN: J27.3, R130.2
/OPAMP4_IP: J27.1, R129.2
/PA0: J5.7, KEY6.1, R173.2, U12.34 (PA0)
/PA1: J5.9, KEY7.1, R174.2, U12.35 (PA1)
/PA2: J5.11, KEY8.1, R175.2, U12.36 (PA2)
/PA3: J5.13, KEY9.1, R176.2, U12.37 (PA3)
/PA6: J5.15, U12.42 (PA6)
/PA7: J5.17, U12.43 (PA7)
/PA8: J6.5, U12.100 (PA8)
/PA9: J6.7, U12.101 (PA9)
/PA10: J6.9, U12.102 (PA10)
/PA11: J6.11, U12.103 (PA11)
/PA12: J6.13, U12.104 (PA12)
/PB0: J5.6, R203.2, U12.46 (PB0)
/PB1: J5.8, R204.2, U12.47 (PB1)
/PB5: R208.2, U12.135 (PB5)
/PB6: R137.1, U12.136 (PB6)
/PB7: R136.1, U12.137 (PB7)
/PB8: R135.1, U12.139 (PB8)
/PB9: R134.1, U12.140 (PB9)
/PC0: J5.1, R160.2, U12.26 (PC0)
/PC1: J5.3, R161.2, U12.27 (PC1)
/PC2: J5.5, R162.2, U12.28 (PC2)
/PC6: J4.14, R196.2, U12.96 (PC6)
/PC7: J4.16, R197.2, U12.97 (PC7)
/PC8: J6.1, R158.1, SD1.7 (DAT0(D0)), U12.98 (PC8)
/PC9: J6.3, R159.1, SD1.8 (DAT1(RSV)), U12.99 (PC9)
/PC10: J6.15, R163.1, SD1.1 (DAT2(RSV)), U12.111 (PC10)
/PC11: J6.17, R182.1, SD1.2 (CDAT3/CS), U12.112 (PC11)
/PC12: J6.19, SD1.5 (CLK), U12.113 (PC12)
/PC13: J3.11, R170.1, U12.7 (PC13)
/PC14: J3.13, R171.1, U12.8 (PC14)
/PC15: J3.15, R172.1, U12.9 (PC15)
/PD0: J6.2, R180.2, U12.114 (PD0)
/PD1: J6.4, R181.2, U12.115 (PD1)
/PD2: J6.6, R198.1, SD1.3 (CMD), U12.116 (PD2)
/PD3: J6.8, R183.2, R199.1, SD1.9 (CD), U12.117 (PD3)
/PD4: J6.10, R184.2, U12.118 (PD4)
/PD5: J6.12, R185.2, U12.119 (PD5)
/PD6: J6.14, R186.2, U12.122 (PD6)
/PD7: J6.16, R187.2, U12.123 (PD7)
/PD8: J4.1, R188.2, U12.77 (PD8)
/PD9: J4.3, R189.2, U12.78 (PD9)
/PD10: J4.5, R190.2, U12.79 (PD10)
/PD11: J4.7, R191.2, U12.80 (PD11)
/PD12: J4.9, R192.2, U12.81 (PD12)
/PD13: J4.11, R193.2, U12.82 (PD13)
/PD14: J4.13, R194.2, U12.85 (PD14)
/PD15: J4.15, R195.2, U12.86 (PD15)
/PE0: R219.2, U12.141 (PE0)
/PE1: R220.2, U12.142 (PE1)
/PE2: J3.1, R148.1, U12.1 (PE2)
/PE3: J3.3, R147.1, U12.2 (PE3)
/PE4: J3.5, R146.1, U12.3 (PE4)
/PE5: J3.7, R145.1, U12.4 (PE5)
/PE6: J3.9, R144.1, U12.5 (PE6)
/PE7: J5.16, R213.2, U12.58 (PE7)
/PE8: J5.18, R214.2, U12.59 (PE8)
/PE10: R215.2, U12.63 (PE10)
/PE12: R216.2, U12.65 (PE12)
/PE14: R217.2, U12.67 (PE14)
/PE15: R218.2, U12.68 (PE15)
/PF0: J3.17, R149.1, U12.10 (PF0)
/PF1: J3.19, R150.1, U12.11 (PF1)
/PF2: J3.2, R151.1, U12.12 (PF2)
/PF3: J3.4, R152.1, U12.13 (PF3)
/PF4: J3.6, R153.1, U12.14 (PF4)
/PF5: J3.8, R154.1, U12.15 (PF5)
/PF6: J3.10, R155.1
/PF7: J3.12, R156.1
/PF8: J3.14, R157.1
/PF10: J3.18, R164.2, U12.22 (PF10)
/PF11: R165.2, U12.49 (PF11)
/PF12: R166.2, U12.50 (PF12)
/PF13: R167.2, U12.53 (PF13)
/PF14: R168.2, U12.54 (PF14)
/PF15: R169.2, U12.55 (PF15)
/PG0: J5.12, R221.2, U12.56 (PG0)
/PG1: J5.14, R222.2, U12.57 (PG1)
/PG2: J4.17, R223.2, U12.87 (PG2)
/PG3: J4.19, R224.2, U12.88 (PG3)
/PG4: J4.4, R225.2, U12.89 (PG4)
/PG5: J4.6, R226.2, U12.90 (PG5)
/PG6: J4.8, R227.2, U12.91 (PG6)
/PG7: J4.10, U6.12 (~DRDY), U12.92 (PG7)
/PG9: R177.2, U12.124 (PG9)
/PG10: R178.2, U12.125 (PG10)
/PG11: R179.2, U12.126 (PG11)
/PG15: R207.2, U12.132 (PG15)
/REF_1.25V: J1.8, R27.1
/REF_2.5V: J1.6, R26.1
/REF_3V: J1.4, R25.1
/STM32_BEEP: R138.1, U12.74 (PB13)
/STM32_BOOT0: R44.2, U12.138 (BOOT0)
/STM32_BOOT1: R45.2, U12.48 (PB2)
/STM32_DAC_OUT1: R96.1, U12.40 (PA4)
/STM32_DAC_OUT2: R97.1, U12.41 (PA5)
/STM32_ETH_ELINK: ETH2.10, ETH2.11, U14.52 (ELINK#)
/STM32_ETH_SCK: U12.19 (PF7), U14.60 (SCK)
/STM32_ETH_SCS: U12.18 (PF6), U14.59 (SCS)
/STM32_ETH_SDI: U12.20 (PF8), U14.61 (SDI)
/STM32_ETH_SDO: U12.21 (PF9), U14.62 (SDO)
/STM32_SPI6_MISO: U6.13 (DOUT), U12.127 (PG12)
/STM32_SPI6_MOSI: U6.14 (DIN), U12.129 (PG14)
/STM32_SPI6_NSS: J4.12, U6.4 (~CS), U12.93 (PG8)
/STM32_SPI6_SCK: U6.1 (SCLK), U12.128 (PG13)
/STM32_USB_DM: R132.2, U12.75 (PB14)
/STM32_USB_DP: R133.2, U12.76 (PB15)
/STM32_USB_ID: J3.16, U12.73 (PB12)
/ST_HALL_CH1: J11.1, U12.60 (PE9)
/ST_HALL_CH2: J11.5, U12.64 (PE11)
/ST_HALL_CH3: J11.9, U12.66 (PE13)
/ST_JTDI: ST_JTAG1.5, SW1.8, U12.110 (PA15)
/ST_JTDO: ST_JTAG1.6, SW1.7, U12.133 (PB3)
/TM7707_RST: C17.1, R16.1, U6.5 (~RESET)
/TP3: L1.1, R8.2, TP3.1, U3.5 (VOUT)
/TP24: C97.2, J13.2, R96.2, TP24.1
/TP25: C98.2, J13.4, R97.2, TP25.1
/TP27: C96.2, J28.2, R131.1, TP27.1
/USB_PWR_IN: C28.1, L2.1, USB1.2 (A4/B9), USB1.11 (A9/B4), USB2.2 (A4/B9), USB2.11 (A9/B4)
/VBUS: J2.1, POWER1.2, POWER1.5
/VCORE: C33.2, C38.2, C39.2, C40.2, U10.12 (VCORE), U10.37 (VCORE), U10.49 (VREGOUT), U10.64 (VCORE)
unnamed: 1V8_PWR1.2 (A), R3.1
unnamed: 3V3_PWR1.2 (A), R2.1
unnamed: 5V_PWR1.2 (A), R1.2
unnamed: BEEP1.2 (-), D1.2 (A), Q1.3 (C)
unnamed: BOOT_MODE1.1, R43.1, R44.1
unnamed: BOOT_MODE1.2, R42.1, R45.1
unnamed: BOOT_MODE2.1, R62.1, R63.1
unnamed: BOOT_MODE2.2, R61.1, R64.1
unnamed: C99.2, J12.2, J12.4, J12.6, J12.8, J12.10, J12.12, J12.14, J12.16, J12.18, J12.20, J13.1, J13.3, J13.5
unnamed: ESD1.1 (A1), R28.1, USB1.5 (B7), USB1.7 (A7)
unnamed: ESD2.1 (A1), R29.1, USB1.6 (A6), USB1.8 (B6)
unnamed: ESD3.1 (A1), R132.1, USB2.5 (B7), USB2.7 (A7)
unnamed: ESD4.1 (A1), R133.1, USB2.6 (A6), USB2.8 (B6)
unnamed: ETH1.9, R47.1
unnamed: ETH1.12, R46.1
unnamed: ETH2.9, R54.1
unnamed: ETH2.12, R53.1
unnamed: F1.2, POWER1.3, POWER1.6
unnamed: J1.1, J1.3, J1.5, J1.7, R23.2
unnamed: J2.2, L2.2
unnamed: J11.2, R90.1, R93.1
unnamed: J11.6, R91.1, R94.1
unnamed: J11.10, R92.1, R95.1
unnamed: J13.6, R98.2, R99.2
unnamed: J14.1, R100.2
unnamed: J14.3, R101.2
unnamed: J15.1, R102.2
unnamed: J15.3, R103.2
unnamed: J16.1, R104.2
unnamed: J16.3, R105.2
unnamed: J17.1, R106.2
unnamed: J17.3, R107.2
unnamed: J18.1, R108.2
unnamed: J18.3, R109.2
unnamed: J21.6, R116.2
unnamed: KEY1.2, R77.1
unnamed: KEY2.2, R78.1
unnamed: KEY3.2, R79.1
unnamed: KEY4.2, R80.1
unnamed: KEY5.4 (COMMON), R81.1
unnamed: KEY6.2, R140.1
unnamed: KEY7.2, R141.1
unnamed: KEY8.2, R142.1
unnamed: KEY9.2, R143.1
unnamed: LED1.2 (A), R82.2
unnamed: LED2.2 (A), R83.2
unnamed: LED3.2 (A), R84.2
unnamed: LED4.2 (A), R85.2
unnamed: LED5.2 (A), R86.2
unnamed: LED6.2 (A), R87.2
unnamed: LED7.2 (A), R88.2
unnamed: LED8.2 (A), R89.2
unnamed: LED9.2 (A), R134.2
unnamed: LED10.2 (A), R135.2
unnamed: LED11.2 (A), R136.2
unnamed: LED12.2 (A), R137.2
unnamed: Q1.1 (B), R138.2, R139.2
unnamed: R76.1, SCREEN1.5 (~RESET)
unnamed: R4.1, R5.2, U1.4 (BP/FB)
unnamed: R6.1, R7.2, U2.4 (BP/FB)
unnamed: R8.1, R9.2, U3.4 (BP/FB)
unnamed: R11.2, U4.7 (REF1)
unnamed: R10.2, U4.6 (REF2)
unnamed: R14.2, U5.7 (REF1)
unnamed: R13.2, U5.6 (REF2)
unnamed: U6.2 (MCLK_IN), X1.3 (OUT)
unnamed: C16.1, U6.3 (MCLK_OUT)
unnamed: C24.2, R23.1, U6.9 (REF_IN(+))
unnamed: R24.2, U6.10 (REF_IN(-))
unnamed: C25.2, R25.2, U7.2 (OUT)
unnamed: C26.2, R26.2, U8.2 (OUT)
unnamed: C27.2, R27.2, U9.2 (OUT)
unnamed: R28.2, U10.7 (DM)
unnamed: R29.2, U10.8 (DP)
unnamed: R35.1, U10.62 (EECLK), U11.4 (CLK)
unnamed: R34.1, U10.63 (EECS), U11.5 (CS)
unnamed: R32.2, U10.61 (EEDATA), U11.3 (DI)
unnamed: C36.1, U10.2 (OSCI), X2.3 (OSC2)
unnamed: C37.1, U10.3 (OSCO), X2.1 (OSC1)
unnamed: R31.1, U10.6 (REF)
unnamed: C29.1, C30.1, L3.1, U10.4 (VPHY)
unnamed: C31.1, C32.1, L4.1, U10.9 (VPLL)
unnamed: C34.2, R30.2, U10.14 (~RESET)
unnamed: R32.1, R33.2, U11.1 (DO)
unnamed: C45.2, R40.2, ST_RESET1.2, U12.25 (NRST)
unnamed: C46.2, R41.1, U12.23 (PH0), X3.3 (OSC2)
unnamed: C47.2, R41.2, U12.24 (PH1), X3.1 (OSC1)
unnamed: C71.2, U12.71 (VCAP_1)
unnamed: C72.2, U12.106 (VCAP_2)
unnamed: R52.2, U13.1 (RSETE)
unnamed: C75.1, U13.36 (RSTI)
unnamed: C73.2, U13.10 (XI), X4.3 (OSC2)
unnamed: C74.2, U13.11 (XO), X4.1 (OSC1)
unnamed: R59.2, U14.1 (RSETE)
unnamed: C78.1, U14.36 (RSTI)
unnamed: C76.2, U14.10 (XI), X5.3 (OSC2)
unnamed: C77.2, U14.11 (XO), X5.1 (OSC1)
unnamed: R65.2, R68.1, U15.1 (A0)
unnamed: R66.2, R69.1, U15.2 (A1)
unnamed: R67.2, R70.1, U15.3 (A2)
unnamed: R75.2, U16.9 (AD0)
unnamed: C83.2, U16.20 (CPOUT)
unnamed: C84.1, U16.10 (REGOUT)
VSS: 1V8_PWR1.1 (K), 3V3_PWR1.1 (K), 5V_PWR1.1 (K), AKINA_JTAG1.4, AKINA_JTAG1.8, AKINA_JTAG1.10, AKINA_RESET1.1, BAT1.2 (-), BOOT_MODE1.3, BOOT_MODE1.4, BOOT_MODE2.3, BOOT_MODE2.4, BTB100x1.14, BTB100x1.26, BTB100x1.50, BTB100x1.69, BTB100x1.76, BTB100x1.100, BTB100x1.109, BTB100x1.110, BTB100x1.111, BTB100x1.150, BTB100x1.164, BTB100x1.200, C1.2, C2.2, C3.2, C4.2, C5.2, C6.2, C7.2, C8.2, C9.1, C10.1, C11.1, C12.1, C13.1, C14.2, C15.2, C16.2, C17.2, C22.2, C23.2, C24.1, C25.1, C26.1, C27.1, C28.2, C29.2, C30.2, C31.2, C32.2, C33.1, C34.1, C35.2, C36.2, C37.2, C38.1, C39.1, C40.1, C41.1, C42.1, C43.1, C44.1, C45.1, C46.1, C47.1, C48.2, C49.2, C50.2, C51.2, C52.2, C53.2, C54.2, C55.2, C56.2, C57.2, C58.2, C59.2, C60.2, C61.2, C62.2, C63.2, C64.2, C65.2, C67.2, C68.2, C69.2, C70.2, C71.1, C72.1, C73.1, C74.1, C75.2, C76.1, C77.1, C78.2, C79.2, C80.2, C81.2, C82.2, C83.1, C84.2, C85.2, C86.2, C87.2, C96.1, C97.1, C98.1, C99.1, C100.2, C101.2, ESD1.2 (A2), ESD2.2 (A2), ESD3.2 (A2), ESD4.2 (A2), ETH1.8 (P8/GND), ETH1.13 (SH), ETH1.14 (SH), ETH2.8 (P8/GND), ETH2.13 (SH), ETH2.14 (SH), J3.20, J4.2, J4.18, J4.20, J5.10, J5.19, J5.20, J7.17, J7.19, J8.13, J11.3, J11.4, J11.7, J11.8, J11.11, J11.12, J14.2, J14.4, J15.2, J15.4, J16.2, J16.4, J17.2, J17.4, J18.2, J18.4, J20.2, J20.4, J20.6, J21.2, J21.4, J22.2, J22.4, J22.6, J23.2, J23.4, J23.6, J24.2, J25.2, J26.2, J27.2, J28.3, LED1.1 (K), LED2.1 (K), LED3.1 (K), LED4.1 (K), LED5.1 (K), LED6.1 (K), LED7.1 (K), LED8.1 (K), LED9.1 (K), LED10.1 (K), LED11.1 (K), LED12.1 (K), Q1.2 (E), R5.1, R7.1, R9.1, R10.1, R11.1, R13.1, R14.1, R19.1, R22.1, R24.1, R31.2, R52.1, R59.1, R68.2, R69.2, R70.2, R75.1, R99.1, R139.1, SCREEN1.1 (GND), SD1.6 (VSS), SD1.10 (GND), SD1.11 (GND), SD1.12 (GND), SD1.13 (GND), ST_JTAG1.4, ST_JTAG1.8, ST_JTAG1.10, ST_RESET1.1, T1.1, T2.1, T3.1, T4.1, TP2.1, TP5.1, TP8.1, TP11.1, TP13.1, TP17.1, TP19.1, TP21.1, TP26.1, TP28.1, TP30.1, U1.2 (GND), U2.2 (GND), U3.2 (GND), U4.1 (NC), U4.4 (GND), U5.1 (NC), U5.4 (GND), U6.16 (GND), U7.3 (GND), U8.3 (GND), U9.3 (GND), U10.1 (GND), U10.5 (GND), U10.10 (AGND), U10.11 (GND), U10.13 (TEST), U10.15 (GND), U10.25 (GND), U10.35 (GND), U10.47 (GND), U10.51 (GND), U11.2 (VSS), U12.16 (VSS), U12.31 (VSSA), U12.38 (VSS), U12.51 (VSS), U12.61 (VSS), U12.83 (VSS), U12.94 (VSS), U12.107 (VSS), U12.120 (VSS), U12.130 (VSS), U13.3 (GND), U13.9 (GND), U13.13 (GND), U13.18 (GND), U13.20 (GND), U13.37 (GND), U13.41 (GND), U13.44 (GND), U13.48 (GND), U14.3 (GND), U14.9 (GND), U14.13 (GND), U14.18 (GND), U14.20 (GND), U14.37 (GND), U14.41 (GND), U14.44 (GND), U14.48 (GND), U15.4 (VSS), U15.7 (WP), U16.1 (CLKIN), U16.11 (FSYNC), U16.18 (GND), U16.25 (GND), U17.4 (GND), USB1.1 (A1/B12), USB1.12 (A12/B1), USB1.S1 (SHELL), USB1.S2 (SHELL), USB1.S3 (SHELL), USB1.S4 (SHELL), USB2.1 (A1/B12), USB2.12 (A12/B1), USB2.S1 (SHELL), USB2.S2 (SHELL), USB2.S3 (SHELL), USB2.S4 (SHELL), X1.2 (GND), X2.2 (GND), X2.4 (GND), X3.2 (GND), X3.4 (GND), X4.2 (GND), X4.4 (GND), X5.2 (GND), X5.4 (GND)
