ojeffreyo/PSVB_EvalBoard/(commit log)

2023-04-18 Updated new PSVB hardware design.
    [PSVB_EvalBoard.kicad_pcb, PSVB_EvalBoard.kicad_sch]
2023-04-21 update PSVB hardware design
    [PSVB_EvalBoard.kicad_sch]
2023-04-21 Almost finished the schematic design
    [PSVB_EvalBoard.kicad_sch]
2023-04-23 update PCB design
    [PSVB_EvalBoard.kicad_pcb, PSVB_EvalBoard.kicad_sch]
2023-04-28 Updated PCB design
    [PSVB_EvalBoard.kicad_pcb, PSVB_EvalBoard.kicad_sch]
2023-05-04 updated PCB design-2023-5-24
    [PSVB_EvalBoard.kicad_pcb, PSVB_EvalBoard.kicad_sch]
2023-05-05 almost finished the PCB design
    [PSVB_EvalBoard.kicad_pcb, PSVB_EvalBoard.kicad_sch]
2023-05-06 80 lines unconnected
    [PSVB_EvalBoard.kicad_pcb, PSVB_EvalBoard.kicad_sch]
2023-05-06 almost finished
    [PSVB_EvalBoard.kicad_pcb]
2023-05-08 i need one day more
    [PSVB_EvalBoard.kicad_pcb]
2023-05-09 Generated some PCB outputs.
    [PSVB_EvalBoard.kicad_pcb]
2023-05-09 24 lines not connected, almost done.
    [PSVB_EvalBoard.kicad_pcb]
2023-05-10 Finished the PCB layout
    [PSVB_EvalBoard.kicad_pcb, PSVB_EvalBoard.kicad_sch]
2023-05-11 Did some modification.
    [PSVB_EvalBoard.kicad_pcb, PSVB_EvalBoard.kicad_sch]
2023-05-12 Fixed some issues.
    [PSVB_EvalBoard.kicad_pcb]
2023-05-12 Finished PCB layout.
    [PSVB_EvalBoard.kicad_pcb, PSVB_EvalBoard.kicad_sch]
2023-05-12 Project finished.
    [PSVB_EvalBoard.kicad_sch]
2023-05-16 Fix some errors.
    [PSVB_EvalBoard.kicad_sch]
2023-05-16 Updated silkscreen.
2023-05-17 Finished the bottom silkscreen.
    [PSVB_EvalBoard.kicad_sch]
2023-05-17 Did some modification on top-silkscreen.
2023-05-17 Finished PCB design.
    [PSVB_EvalBoard.kicad_sch]
2023-05-17 Gerber generated.
    [PSVB_EvalBoard-NPTH.drl, PSVB_EvalBoard-PTH.drl, PSVB_EvalBoard-job.gbrjob]
2023-05-17 Finished all the things.
    [PSVB_EvalBoard-B_Cu.gbr, PSVB_EvalBoard-B_Mask.gbr, PSVB_EvalBoard-B_Paste.gbr, PSVB_EvalBoard-B_Silkscreen.gbr, PSVB_EvalBoard-Edge_Cuts.gbr, PSVB_EvalBoard-F_Cu.gbr, PSVB_EvalBoard-F_Mask.gbr, PSVB_EvalBoard-F_Paste.gbr]
